Mottramlabs/ESP32-4-Channel-Mains-Current-Sensor/Pictures/201185-Dims.png

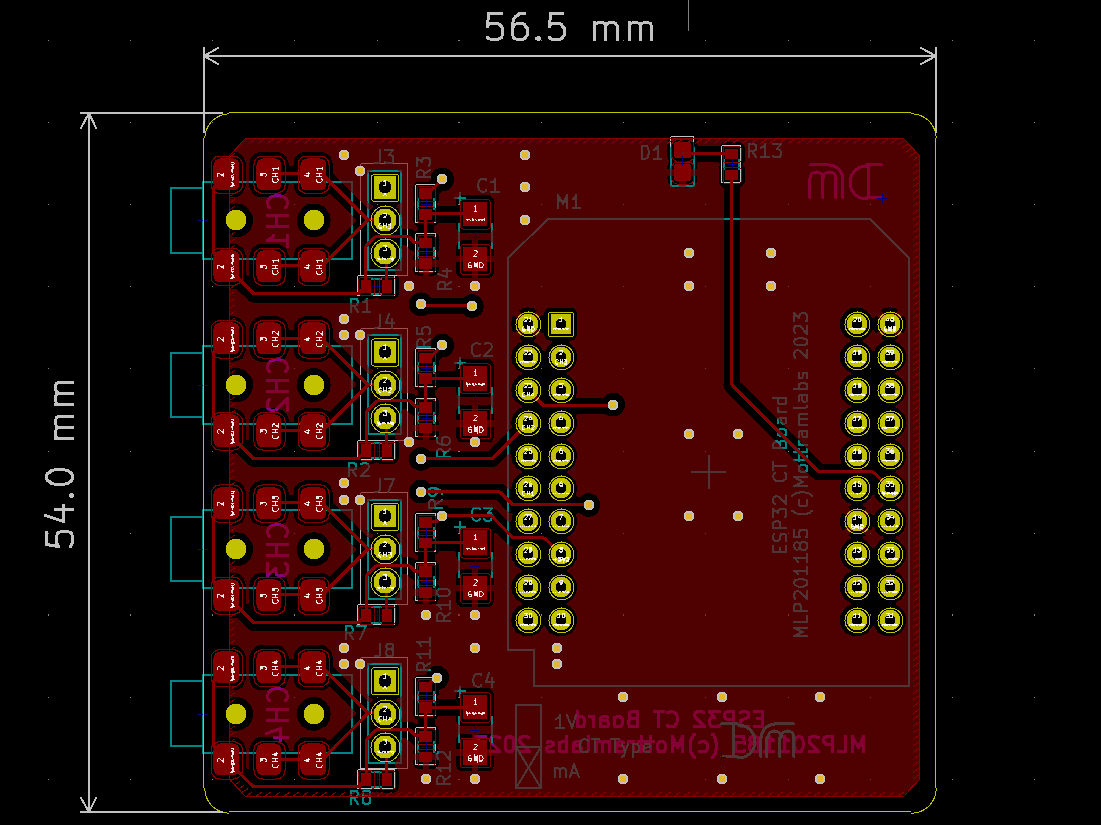
Pictures/201185-Dims.png
