Mottramlabs/ESP32-4-Channel-Mains-Current-Sensor/Pictures/201188-Dims.png

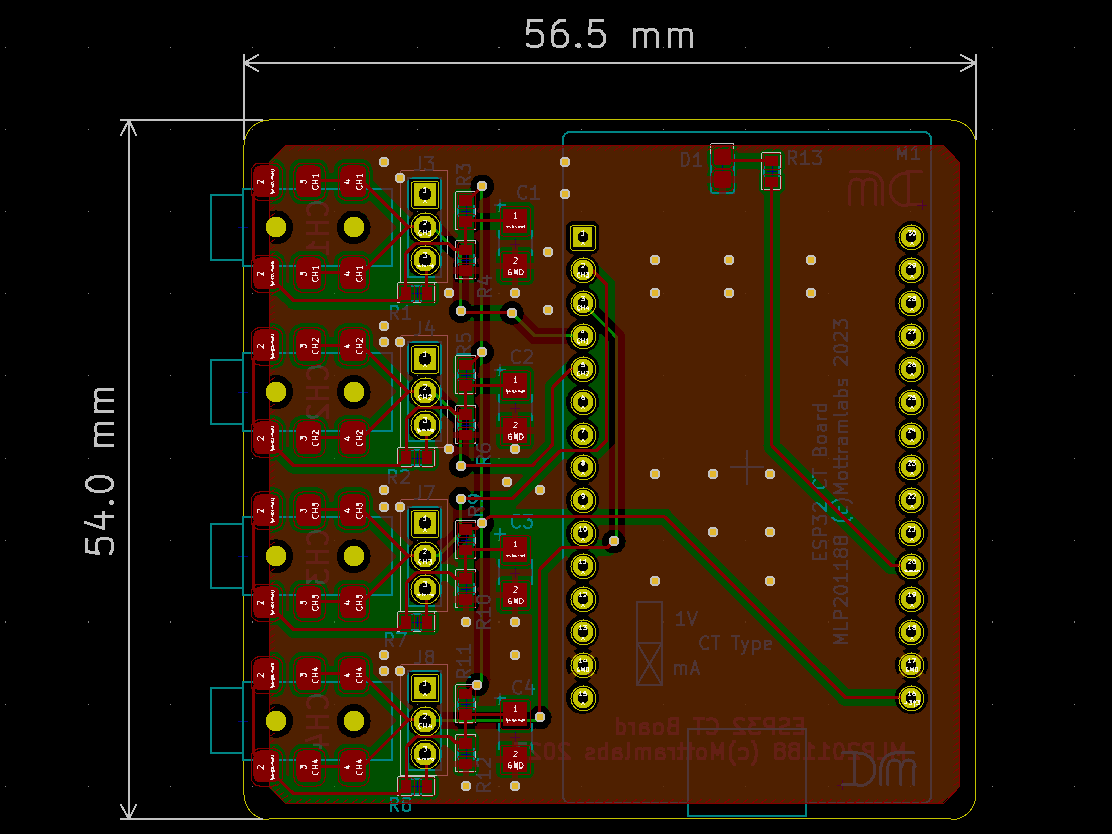
Pictures/201188-Dims.png
