Mottramlabs/ESP32-4-Channel-Mains-Current-Sensor/Pictures/201191-Dims.png

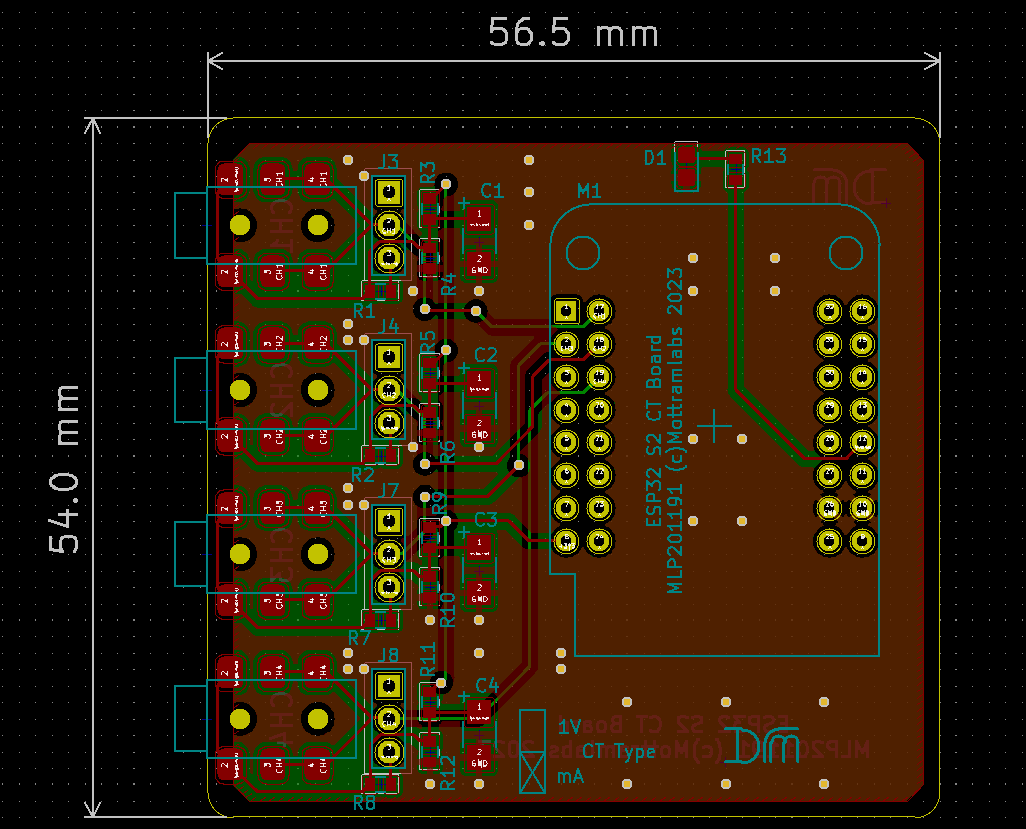
Pictures/201191-Dims.png
