Mottramlabs/ESP32-4-Channel-Mains-Current-Sensor/(threads)

Thread 1 (2023-07-13):

ESP Home Code

talldrin, 2023-07-13:
I just purchased one of these from your ebay store. Do you have the code setup for ESP Home that you could provide? I am planning on using this with home assistant.

swoopgrandchamp, 2023-10-31:
The following code is working in a ESP32.
Note that my voltage sensor comes from homeassistant, you can use a fixed value if you want or don't have a voltage meter.

```
substitutions:
  update_time: never
  disp_name: "house-power-sensor"

esphome:
  name: house-power-sensor
  friendly_name: house-power-sensor

esp32:
  board: esp32dev
  framework:
    type: arduino

# Enable logging
logger:
  level: debug

# Enable Home Assistant API
api:
  encryption:
    key: "USE YOUR ENCRYPTION KEY HERE"

ota:

wifi:
  ssid: !secret wifi_ssid
  password: !secret wifi_password
  ap:
    ssid: "house-power-sensor"
    password: "PROVIDE AP PASSWORD"

time:
  - platform: homeassistant
    id: homeassistant_time

interval:
  - interval: 5s
    then:
      - script.execute: readCTs
script:
  - id: readCTs
    then:
      - component.update: ct1Amps
      - delay: 500ms
      - component.update: ct1Watts
      - delay: 500ms
      - component.update: ct2Amps
      - delay: 500ms
      - component.update: ct2Watts
      - delay: 500ms
      - component.update: ct3Amps
      - delay: 500ms
      - component.update: ct3Watts
      - delay: 500ms
      - component.update: ct4Amps
      - delay: 500ms

switch:
   - platform: restart
     name: "Restart"

sensor:
  - platform: ct_clamp
    sensor: adc_sensor_1
    name: ct1Amps
    id: ct1Amps
    update_interval: never
    sample_duration: 200ms
    filters:
      - calibrate_linear:
          - 0 -> 0
          - 0.07972 -> 7.72

  - platform: adc
    pin: GPIO34
    id: adc_sensor_1
    attenuation: 11db
    internal: true

  - platform: ct_clamp
    sensor: adc_sensor_2
    name: ct2Amps
    id: ct2Amps
    update_interval: never
    sample_duration: 200ms
    filters:
      - calibrate_linear:
          - 0 -> 0
          - 0.08278 -> 7.71

  - platform: adc
    pin: GPIO35
    id: adc_sensor_2
    attenuation: 11db
    internal: true

  - platform: ct_clamp
    sensor: adc_sensor_3
    name: ct3Amps
    id: ct3Amps
    update_interval: never
    sample_duration: 200ms
    filters:
      - calibrate_linear:
          - 0 -> 0
          - 0.08317 -> 7.84

  - platform: adc
    pin: GPIO36
    id: adc_sensor_3
    attenuation: 11db
    internal: true

  - platform: ct_clamp
    sensor: adc_sensor_4
    name: ct4Amps
    id: ct4Amps
    update_interval: never
    sample_duration: 200ms
    #filters:
      #- calibrate_linear:
          #- 0 -> 0
          #- 0.08277 -> 7.80

  - platform: adc
    pin: GPIO39
    id: adc_sensor_4
    attenuation: 11db
    internal: true

  - platform: wifi_signal
    name: "wifi_signal"
    update_interval: 1min
  - platform: uptime
    name: "uptime"
    id: Uptime
    update_interval: 1min

#Watts per channel
  - platform: template
    name: CT1 Watts
    id: ct1Watts
    lambda: return id(ct1Amps).state * id(ic1Volts).state;
    accuracy_decimals: 0
    unit_of_measurement: W
    icon: "mdi:flash-circle"
    update_interval: never

  - platform: template
    name: CT2 Watts
    id: ct2Watts
    lambda: return id(ct2Amps).state * id(ic1Volts).state;
    accuracy_decimals: 0
    unit_of_measurement: W
    icon: "mdi:flash-circle"
    update_interval: never

  - platform: template
    name: CT3 Watts
    id: ct3Watts
    lambda: return id(ct3Amps).state * id(ic1Volts).state;
    accuracy_decimals: 0
    unit_of_measurement: W
    icon: "mdi:flash-circle"
    update_interval: never

  - platform: total_daily_energy
    name: CT1 Total kWh
    power_id: ct1Watts
    filters:
      - multiply: 0.001
    unit_of_measurement: kWh
    icon: "mdi:flash"

  - platform: total_daily_energy
    name: CT2 Total kWh
    power_id: ct2Watts
    filters:
      - multiply: 0.001
    unit_of_measurement: kWh
    icon: "mdi:flash"

  - platform: total_daily_energy
    name: CT3 Total kWh
    power_id: ct3Watts
    filters:
      - multiply: 0.001
    unit_of_measurement: kWh
    icon: "mdi:flash"

  - platform: template
    name: Total Amps
    id: totalAmps
    lambda: return id(ct1Amps).state + id(ct2Amps).state + id(ct3Amps).state ;
    accuracy_decimals: 2
    unit_of_measurement: A
    icon: "mdi:flash"
    update_interval: 15s

  - platform: template
    name: Total Watts
    id: totalWatts
    lambda: return id(totalAmps).state * id(ic1Volts).state;
    accuracy_decimals: 1
    unit_of_measurement: W
    icon: "mdi:flash"
    update_interval: 15s

  - platform: total_daily_energy
    name: Total kWh
    power_id: totalWatts
    filters:
      - multiply: 0.001
    unit_of_measurement: kWh
    icon: "mdi:flash"

  - platform: homeassistant
    name: "Voltage"
    id: ic1Volts
    entity_id: sensor.house_voltage
    internal: true

  - platform: template
    name: Voltage
    id: voltageupdate
    lambda: return id(ic1Volts).state;
    accuracy_decimals: 1
    unit_of_measurement: V
    update_interval: 60s
```

talldrin, 2023-10-31:
Thanks! I will give it try.

Matt2k34, 2023-11-13:
> Thanks! I will give it try.

Did this work for you?

> The following code is working in a ESP32. Note that my voltage sensor comes from homeassistant, you can use a fixed value if you want or don't have a voltage meter.

Thank you for this! This has got me close, but I'm having issues calibrating via calibrate_linear. I think I'm being dense because I'm not sure what number I should be using.

I'm assuming it should be:
[22:49:43][D][sensor:094]: 'ct1Amps': Sending state 0.15046 A with 2 decimals of accuracy
This is my zero load state.
&
[22:50:28][D][sensor:094]: 'ct1Amps': Sending state 0.33105 A with 2 decimals of accuracy
this is with a 2kw resistive load.

I believe this means it should be:
      - calibrate_linear:
          - 0.15046 -> 0
          - 0.33105 -> 8.16

(2000/245v - to give me 8.16A) - I'm having issues regardless how I calculate this with being unable to zero, and receiving either negative or huge wattage numbers.

e..g the above now becomes:
-1,623W instead of zero.

[22:54:24][D][sensor:094]: 'ct1Amps': Sending state -6.62770 A with 2 decimals of accuracy
[22:54:25][D][sensor:094]: 'CT1 Watts': Sending state -1623.78662 W with 0 decimals of accuracy

Any assistance appreciated. I've never done calibrate_linear before and I feel like I'm missing something. I'm using the ESP32 - 30 pin version (devkit v1) and I've tried cutting this down to just the CT1 config to make it easier to read the logs etc, and it was no help.

Any help appreciated. I feel like I'm getting nowhere with the documentation / other examples for calibration

Thanks!

also FYI: Some of the CT4 stuff is missing in your code above :)

PeteBa, 2023-11-14:
By way of example, a common SCT013-000 will theoretically generate a 0V signal at the ESP32 gpio pin when there is a 0 amp load connected through the CT. Similarly, the same CT will generate a 1.1V signal at the ESP32 when there is a 100A load. This provides a pretty good starting point for calibrating the `ct_clamp` platform using the following filter config:

```
- calibrate_linear:
     method: exact
     datapoints:
        - 0 -> 0
        - 1.1 -> 100
```

If you want to improve low current readings then you can remove any load wire through the CT and look for the corresponding "RAW AC" line in the ESPHOME log. The number here is the left side of the correlation mapping as it basically represent the voltage at the gpio pin. The right side should be set to zero as that represents the load current.. In essence, we have added a second correlation line that maps low values to zero rather than having them go negative:

```
[13:18:54][D][ct_clamp:041]: 'Channel 4 Current' - Raw AC Value: 0.001A after 229 different samples (1145 SPS)

- calibrate_linear:
     method: exact
     datapoints:
        - 0 -> 0
        - 0.001 -> 0
        - 1.1 -> 100
```

If you have a multimeter that can measure resistance values then you can go a further step to improve that last correlation pair. The `1.1 -> 100` mapping assumes that the board is using a 22 ohm resistor to convert the 50mA signal that the CT produces at 100A into a 1.1V signal at the gpio pin. This is based on ohms law that voltage = current x resistance. So 0.05 x 22 is equal to 1.1V. However, the resistor is not generally exactly 22 ohms rather it is nominally within +/-1%. Mine is 22.25 ohms. So I can improve the correlation a little bit by using 1.1125 (i.e. 0.05 x 22.25) as the new left side of the last correlation mapping:

- calibrate_linear:
     method: exact
     datapoints:
        - 0 -> 0
        - 0.001 -> 0
        - 1.1125 -> 100
```

This gets me to within a few percent of my reference meter that has higher tolerance resistors, internal voltage reference, 12bit ADC, high frequency sampling/smoothing etc. Not bad for a relatively inexpensive board.

I struggle with using things like a 60W bulb or 2kW space heaters to create correlation maps as there are too many wide tolerances involved that can easily make derived calibrations spurious. For a start these loads are at the low end of the CT's range and you would really want something at the high end. But loads of 80-100A are pretty hard to create and measure in the average home. You then have the difficulty of converting watts to amps given that residential voltages can easily vary +/-10% from nominal. But mileage may vary on this.

Hopefully helpful.
```
substitutions:
  devicename: current-sensor
  friendlyname: Current Sensor

esphome:
  name: ${devicename}
  friendly_name: ${friendlyname}

esp32:
  board: esp32dev
  framework:
    type: arduino

wifi:
  domain: !secret wifi_domain
  ssid: !secret wifi_ssid
  password: !secret wifi_password
  ap:
    ssid: ${devicename}
    password: !secret wifi_ap_password

api:
logger:
ota:

sensor:
  ################ Channel 4 - 100A CT 50mA  ################
  - platform: adc
    pin: GPIO39
    name: Channel 4 ADC
    id: channel_4_adc
    attenuation: 11db
    internal: true

  - platform: ct_clamp
    sensor: channel_4_adc
    name: Channel 4 Current
    id: channel_4_current
    update_interval: 2s
    sample_duration: 200ms
    filters:
      - calibrate_linear:
          method: exact
          datapoints:
            - 0 -> 0
            - 0.001 -> 0           # for CT with non-zero offset
            - 1.1125 -> 100     # For current based CT with 22.25 Ohm burden
      - sliding_window_moving_average:
          window_size: 5
          send_every: 5
          send_first_at: 5
```

Matt2k34, 2023-11-15:
> Hopefully helpful.

100% yes. Thank you very much for this post. It had been driving me crazy and I have (what I think) is a working test bed, and proof that these boards will do exactly what I need (I just need smaller clamps)

Slightly embarrassingly, my issues were:

1. the CT clamp socket being new, when testing the clamp hadn't seated correctly. I must have been knocking the connection and making/breaking it when playing around which is what sent me into wild positive/negative results.
2. Arrows on my CT seemingly are backwards, rather than pointing to the load they point to the source.

I've configured vs 750w, 1250w, and 2000w settings on a resistive heater and it can get within 18w of it at 750/1250 and within 40w of 2000 - More tweaking to do but i'll end up buying some smaller clamps for lower load testing.

Plan is to use the large 100a clamp around connectivity between main consumer unit & loft so I can see directionality into/out of the consumer unit at grid and loft space (solar & batteries) - i'll be able to put about 35-38a load in for that configuration so I *think* that will be ok?

I'll then swap the other inputs to ~20/1V clamps so I can measure lower power / 13a devices.

Honestly, Thank you so much for your help - and for completeness here's (the main sensor section) of the code used. I've pulled in my voltage from HomeAssistant into ESPHome - as the solar battery system has a CT on the mains incoming, I know the incoming voltage pretty accurately. (in the code below, I've used a GROUP (sensor.voltage_group) in Home Assistant, so that if in future I want/need to change the device providing voltage, or I want to average multiple, I can just add the entities in).

It's a shame there's no fleshed out examples on Github / Mottramlabs site - I feel like these boards feel very good quality and they'd sell super well if it was a bit more noob-friendly. (or someone wrote a great guide that didn't assume you knew esphome calibration etc. prior)

Thanks Again!
Matt

`time:
  - platform: homeassistant
    id: homeassistant_time

switch:
   - platform: restart
     name: "Restart"

sensor:

################ Pull Voltage in from Home Assistant  ################

  - platform: homeassistant
    name: "Voltage"
    id: current_voltage_from_ha
    entity_id: sensor.voltage_group
    internal: true

  - platform: template
    name: Voltage
    id: voltageupdate
    lambda: return id(current_voltage_from_ha).state;
    accuracy_decimals: 1
    unit_of_measurement: V
    update_interval: 1s

################ Channel 1 - 100A CT 50mA  ################
  - platform: adc
    pin: GPIO34
    name: Channel 1 ADC
    id: channel_1_adc
    attenuation: 11db
    internal: true

  - platform: ct_clamp
    sensor: channel_1_adc
    name: Channel 1 Current
    id: channel_1_current
    update_interval: 2s
    sample_duration: 200ms
    filters:
      - multiply: 4.0
      - calibrate_linear:
          method: exact
          datapoints:
            #- 0 -> 0
            - 0.003 -> 0           # for CT with non-zero offset
            - 0.089 -> 2     # For current based CT with 22.25 Ohm burden
      - sliding_window_moving_average:
          window_size: 3
          send_every: 3
          send_first_at: 3

##Watts
  - platform: template
    name: CT1 Watts
    id: channel_1_watts
    lambda: return id(channel_1_current).state * id(current_voltage_from_ha).state;
    accuracy_decimals: 0
    unit_of_measurement: W
    icon: "mdi:flash-circle"
    update_interval: 2s

 ################ Channel 2 - 100A CT 50mA  ################
  - platform: adc
    pin: GPIO35
    name: Channel 2 ADC
    id: channel_2_adc
    attenuation: 11db
    internal: true

  - platform: ct_clamp
    sensor: channel_2_adc
    name: Channel 2 Current
    id: channel_2_current
    update_interval: 2s
    sample_duration: 200ms
    filters:
      #- calibrate_linear:
          #method: exact
          #datapoints:
            #- 0 -> 0
            #- 0.002 -> 0           # for CT with non-zero offset
            #- 1.1115 -> 100     # For current based CT with 22.25 Ohm burden
      - sliding_window_moving_average:
          window_size: 5
          send_every: 5
          send_first_at: 5

##Watts
  - platform: template
    name: CT2 Watts
    id: channel_2_watts
    lambda: return id(channel_2_current).state * id(current_voltage_from_ha).state;
    accuracy_decimals: 0
    unit_of_measurement: W
    icon: "mdi:flash-circle"
    update_interval: never

  ################ Channel 3 - 100A CT 50mA  ################

  - platform: adc
    pin: GPIO36
    name: Channel 3 ADC
    id: channel_3_adc
    attenuation: 11db
    internal: true

  - platform: ct_clamp
    sensor: channel_3_adc
    name: Channel 3 Current
    id: channel_3_current
    update_interval: 2s
    sample_duration: 200ms
    filters:
      #- calibrate_linear:
          #method: exact
          #datapoints:
            #- 0 -> 0
            #- 0.002 -> 0           # for CT with non-zero offset
            #- 3.3325 -> 300     # For current based CT with 22.25 Ohm burden
      - sliding_window_moving_average:
          window_size: 5
          send_every: 5
          send_first_at: 5

##Watts
  - platform: template
    name: CT3 Watts
    id: channel_3_watts
    lambda: return id(channel_3_current).state * id(current_voltage_from_ha).state;
    accuracy_decimals: 0
    unit_of_measurement: W
    icon: "mdi:flash-circle"
    update_interval: never

################ Channel 4 - 100A CT 50mA  ################
  - platform: adc
    pin: GPIO39
    name: Channel 4 ADC
    id: channel_4_adc
    attenuation: 11db
    internal: true

  - platform: ct_clamp
    sensor: channel_4_adc
    name: Channel 4 Current
    id: channel_4_current
    update_interval: 2s
    sample_duration: 200ms
    filters:
      #- calibrate_linear:
          #method: exact
          #datapoints:
            #- 0 -> 0
            #- 0.002 -> 0           # for CT with non-zero offset
            #- 1.1125 -> 100     # For current based CT with 22.25 Ohm burden
      - sliding_window_moving_average:
          window_size: 5
          send_every: 5
          send_first_at: 5

##Watts
  - platform: template
    name: CT4 Watts
    id: channel_4_watts
    lambda: return id(channel_4_current).state * id(current_voltage_from_ha).state;
    accuracy_decimals: 0
    unit_of_measurement: W
    icon: "mdi:flash-circle"
    update_interval: never

############# Total Daily Energy - kWh
  - platform: total_daily_energy
    name: CT1 Total kWh
    power_id: channel_1_watts
    filters:
      - multiply: 0.001
    unit_of_measurement: kWh
    icon: "mdi:flash"

############# Total Amps - A
  - platform: template
    name: Total Amps
    id: totalAmps
    lambda: return id(channel_1_current).state + id(channel_2_current).state + id(channel_3_current).state + id(channel_4_current).state ;
    accuracy_decimals: 2
    unit_of_measurement: A
    icon: "mdi:flash"
    update_interval: 15s

############# Total Watts - W
  - platform: template
    name: Total Watts
    id: totalWatts
    lambda: return id(totalAmps).state * id(current_voltage_from_ha).state;
    accuracy_decimals: 1
    unit_of_measurement: W
    icon: "mdi:flash"
    update_interval: 15s

  - platform: total_daily_energy
    name: Total kWh
    power_id: totalWatts
    filters:
      - multiply: 0.001
    unit_of_measurement: kWh
    icon: "mdi:flash"`

PeteBa, 2023-11-16:
Matt, glad the comments were useful. I picked up a few things in your response that I thought interesting and raised a couple of questions/follow-ups. Hope that is OK.

You mention that the CT direction labelling is wrong, can I ask how you determined that ? This board alone cannot measure flow direction as you need simultaneous access to voltage phase to achieve that. If indeed the label is wrong then you probably have counterfeit CTs which is unfortunately common through some online marketplaces. If so then I would replace the CTs through a specialist supplier.

I see you are using a standard two element heater to create your calibration maps. Can I ask if you have a reference meter to reliably determine the actual wattage of the unit before trying to calibrate the CT ? I also have a 750/1250/2000W heater but the numbers on the box are very different to the actual wattage of the device which is 870/1,340/2,210. If I used the box numbers to calibrate the CT then I would be building in a ~10% error. I would be better off sticking with the theoretical calibration  numbers or alternatively buying a relatively cheap but somewhat accurate "kill-a-watt" style device.

One thing to be aware of, If you are going to use lower value CTs then be very careful to only use them on circuits that are guaranteed to have a maximum current load under the nominal value of the CT. For example, passing a 10A load through a 5A CT will likely fry the ESP32 gpio pin. I would suggest always using a higher value CT than the fuse of the circuit being measured for safety.

For completeness, if using a voltage based CT (rather than the 50mA type above). Then the starting point calibration is even easier. The CT will generate 0V when the load is 0A and 1V when the load is at it's nominal value. So for a 30A CT the config would be:

```
- calibrate_linear:
     method: exact
     datapoints:
        - 0 -> 0
        - 1 -> 30
```

Matt2k34, 2023-11-16:
> Hope that is OK.

Of course :D feel free, to ask anything ^

> If indeed the label is wrong then you probably have counterfeit CTs which is unfortunately common through some online marketplaces.

They were indeed, Cheap & cheerful imports from eBay. I'd have to re-test to see if it makes a difference, but in early testing (albeit with issues) it seemed to. I'll see where I can get them for a decent price that might be a little less grey market. These CTs feel pretty shoddy in comparison to other clamps I've used for other things (e.g. EV charger, Solar battery charger). The "YHDC" print on the side I don't think is overly clear making me think they're potentially none genuine. (unless that's "normal")

> Can I ask if you have a reference meter to reliably determine the actual wattage of the unit before trying to calibrate the CT ?
Yes - I've got a 3pin "kill-a-watt" style meter which I trust as accurate (or at least accurate enough) - my heater comes in pretty much smack on the money of the 750/1250/2000.  I've also tested this against a Shelly 1PM which is "there abouts" on my heater & plug in K-A-W. Although not perfect it's probably "good enough" for my needs.

I'll do some better calibration and setup now I know that "this works" as a solution, this has all been a bit rough and ready as a POC really.

> I would suggest always using a higher value CT than the fuse of the circuit being measured for safety.

Yep :) So the thought being 20A/1v CTs will give me enough to cover 13A/220V appliances with plenty of headroom to protect the esp. I'll only use the larger 100A clamps for the cabling between my solar & battery setup, and the main consumer unit (I intend to add extra battery storage meaning it'll be able to push/pull about 48A to/from the main consumer unit under full load - IF I can generate that much usage :) ). Although it's less than "perfect" I'll probably stick to 20A CTs for all "plug in" device monitoring - as anything smaller will likely be fused in the plug at 13A anyway.

Thank you for the example for the voltage CT, this entire thread has been extremely helpful. I found the calibration process infuriating as everyone mentions how to do it - but no one has a "did you check this?" type troubleshooting steps when it doesn't do what you expect.

Joshndroid, 2024-03-25:
Sorry everyone for the bump in this.
I picked up the 4 Port ESP32-s2 version of the boards... Wemos ESP32-S2 Mini
After fighting for a couple days (dead esp32-s2 boards) and ending up needing to bypass the use of esphome web and manually flashing it I at least have a single esp32-s2 board seen by home assistant.
I realised that once i plugged it into the 4-port board, it would no longer find the device.
Searching around I have found here and realised I would need a bit more code to get this going.
I used the example above and slightly changing the top-most section I seem to get an error in relation to the ADC pins.
I have tried searching online for the ADC pins and it seems that the supplied GPIO pins above seem to be correct.

`sensor.adc: [source /config/esphome/wemoss2-4-port.yaml:80]
  platform: adc

  ESP32S2 doesn't support ADC on this pin.
  pin: GPIO34
  id: adc_sensor_1
  attenuation: 11db
  internal: True
sensor.adc: [source /config/esphome/wemoss2-4-port.yaml:97]
  platform: adc

  ESP32S2 doesn't support ADC on this pin.
  pin: GPIO35
  id: adc_sensor_2
  attenuation: 11db
  internal: True
sensor.adc: [source /config/esphome/wemoss2-4-port.yaml:114]
  platform: adc

  ESP32S2 doesn't support ADC on this pin.
  pin: GPIO36
  id: adc_sensor_3
  attenuation: 11db
  internal: True
sensor.adc: [source /config/esphome/wemoss2-4-port.yaml:131]
  platform: adc

  ESP32S2 doesn't support ADC on this pin.
  pin: GPIO39
  id: adc_sensor_4
  attenuation: 11db
  internal: True`

Any tips for this eager user to get this to work (I have YHDC sct-13 clamps 100A/50MA to use on the house to replace a pain in the ass efergy monitor

Joshndroid, 2024-03-29:
I have managed to work out a few things on getting this going... i Have linked this issue in my own separate notes issue to help others with the style that I have.

Thread 2 (2023-09-18):

Bias voltage too high for ESP32 ?

PeteBa, 2023-09-18:
I have a 5 amp CT (SCT013-005) with a 1V output. Unfortunately, current readings appear to max out at around 4.7 amps. I am using the ESP32-S2 board, have the jumper set to 1V and using 11db attenuation.

Looking at the board schematic, I can see the bias voltage is set to 1.65V (i.e. 3.3/2). Given the CT is 1V then the ADC needs to be able to measure voltages between 0.65-2.65V to cover the ct range. However, the esspresif specs [here](https://docs.espressif.com/projects/arduino-esp32/en/latest/api/adc.html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,analogSetAttenuation,%C2%B6,-This%20function%20is) states the widest voltage range to be 0-2.5V when configured with 11db attenuation. Unfortunately, this doesn't cover the full working range of the CT and I suspect the readings are clipped at the high end.

Have I understood this correctly ? I'm a bit new to this stuff so could be misunderstanding things here but, if correct, would it make sense to alter the bias voltage to, say, 1.25V, allowing the full range of measurements.

pskillen, 2023-11-13:
Did you ever resolve this? I'm having trouble getting mine to read anything but zero. The ADC gives a nice floating value when the expansion board isnt connected, but I get the same fixed voltage reading across all 4 channels when the board is connected

Below is with a SCT013-000 (100A) CT with about 30A AC running through it, on a ESP32-WROOM-32. The 1.01400v is the same across all 4 channels
```
[19:29:21][D][ct_clamp:041]: 'Car charger CT' - Raw AC Value: 0.000A after 1 different samples (5 SPS)
[19:29:21][D][sensor:094]: 'Car charger CT': Sending state 0.00000 A with 2 decimals of accuracy
[19:29:25][D][sensor:094]: 'ct_input_1': Sending state 1.01400 V with 2 decimals of accuracy
```

PeteBa, 2023-11-13:
Looking at your log extract, it shows 5 samples per second for the ADC. This should be reading many 100s of samples if setup correctly. You could either have the ESPHome sampling period way to short or the CT is not properly connected. Could the CT be wired incorrectly to the phono jack ? Also, double check, you are shorting the two right-most pins of the 1V/50mA jumper.

My original post above relates to a hardware design choice on the ESP32-S2 board that sets the bias voltage a bit high. This causes readings to be low when measuring currents higher than 50-60% of the CT's nominal value. This can be addressed using the `calibrate_linear` filter.

I use the ESPHome config below for the ESP32-S2 board:

```
esphome:
  name: current-sensor-s2

esp32:
  board: lolin_s2_mini
  variant: ESP32S2
  framework:
    type: arduino

wifi:
  domain: !secret wifi_domain
  ssid: !secret wifi_ssid
  password: !secret wifi_password
  ap:
    password: !secret wifi_ap_password

api:
logger:
ota:

sensor:
################ Channel 4 - 100A CT 50mA  ################
  - platform: adc
    pin: GPIO4
    name: "Current Sensor S2 Channel 4 ADC"
    id: channel_4_adc
    attenuation: 11db
    internal: true

  - platform: ct_clamp
    sensor: channel_4_adc
    name: "Current Sensor S2 Channel 4 Current"
    update_interval: 2s
    sample_duration: 200ms
    filters:
      - calibrate_linear:
          method: exact
          datapoints:
            - 0 -> 0
            - 0.514 -> 51.4
            - 0.788 -> 106.08
      - sliding_window_moving_average:
          window_size: 5
          send_every: 5
          send_first_at: 5
```

pskillen, 2023-11-15:
You're right, my problem is unrelated to this ticket, but you have solved my problem. It was the attenuation - I should have read the docs, but I had convinced myself that it did work at one point, so I assumed I didn't need attentuation. Thanks!

Thread 3 (2024-03-17):

Floating voltage reading when no clamps are plugged in

siparker, 2024-03-17:
I have just put the esphome code from the other issue thread onto my board and plugged just a single clamp into channel 1.

channel 2 and 4 have no reading but channel 3 is reading around 0.2A to 0.4A with nothing plugged into it.

Thread 5 (2024-03-29):

ESP Home Code - ESP32-S2 - Wemos Style - Notes

Joshndroid, 2024-03-29:
Hello all who may find this.

After obtaining the code provided in the other issue - https://github.com/Mottramlabs/ESP32-4-Channel-Mains-Current-Sensor/issues/1

I noticed that the ADC provided would list an error where it says

`ESP32S2 doesn't support ADC on this pin.`

Knocking over a fair bit of googling, etc I couldn't get a grasp on it until i found that the ADC pins are slightly different.
Using this site here - https://www.studiopieters.nl/esp32-s2-pinout/

```
GPIO1  ADC1_CH0
GPIO2 ADC1_CH1
GPIO3 ADC1_CH2
GPIO4 ADC1_CH3

```

Don't use the ADC2 pins listed as these are disabled for wifi

Digging through some more within the schematics of the 4 port board https://github.com/Mottramlabs/ESP32-4-Channel-Mains-Current-Sensor/blob/main/SCH201191.pdf

It listed that the barrel jacks appear to go to 1, 2, 3 & 4.

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

I updated that code to change the GPIO to 1,2,3 & 4 and it validated and got it installed no issues.

Next issue it appeared is that it seemed like the device would randomly disconnect...
Originally i thought it was a power issue but digging through some more docs on ESPHome (https://esphome.io/components/wifi.html) it appears that there is a 'light' power save feature with these so that it must turn off/on wifi. This may be okay later down the line but when your trying to set the device up it makes it super frustrating it just disconnecting. Under the wifi listed the power saving as none.

```
wifi:
  # ...
  power_save_mode: none
```

This has stopped it disconnecting after about 90 seconds or so... This may also assist in getting the dam thing to flash as this disconnect would be a pain in trying to flash it OTA wirelessly during my updates/changes to the yaml.

I have been typing this out for a fair while now and the device is yet to disconnect =]

I found it easier to set a static IP so i have done this in both my DHCP settings within the router but have also backed this up within the device yaml with this from https://esphome.io/components/wifi.html

```
wifi:
  # ...
  manual_ip:
    # Set this to the IP of the ESP
    static_ip: 10.0.0.42
    # Set this to the IP address of the router. Often ends with .1
    gateway: 10.0.0.1
    # The subnet of the network. 255.255.255.0 works for most home networks.
    subnet: 255.255.255.0
```

When you watch the device connect however it does not have any DNS listed so the addition of a DNS1 & DNS2 parameter into the wifi section above below subnet will get you sorted (if necessary)

In essence your WiFi section within the yaml would end up looking something like this

```
wifi:
  ssid: !secret wifi_ssid
  password: !secret wifi_password

  # Optional manual IP
  manual_ip:
    static_ip: 10.0.0.42
    gateway: 10.0.0.1
    subnet: 255.255.255.0
    dns1: 10.0.0.1

  #powersaving WiFi
  power_save_mode: none
```

dantheg1t, 2024-05-24:
Hi @Joshndroid

I have aquired the same hardware as you and I thank you for the notes you have provided, helping to get this setup and working.

Have you managed to get this fully deployed or are you still having issues?

Joshndroid, 2024-05-24:
Hi @dantheg1t

No I played around a little but have put it in the drawer for now.

Have you had any luck with it?

dantheg1t, 2024-05-24:
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

I am just in the process of getting things configured. Haven't had my CT's delivered yet, so early days.

dantheg1t, 2024-05-24:
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

So what are the remaining issues that you have?

Joshndroid, 2024-05-24:
The device seems to go to sleep/off after a while and doesn't want to wake up.

Not sure what the configuration is to disable this. I don't quite understand why.

I put the clamp around my power cable for the pc Setup just to see if I could get a reading and it didn't seem like it.. But I think I need to sort the sleep thing first before I tackle the next bit

jtenniswood, 2024-06-15:
I'm struggling to setup this device, have you had any joy getting it working? If yes, could you share your code!
Thanks!

TheNeutrinoRaged, 2024-12-19:
Thanks for your thread, I got my eps32 s2 and 100/50ma sct working with home assistant (remotely with mqtt) by following along and referring back to issue #1

I've put my tweaked code below, I actually bought a 4 port board but only have 1 Ct for now.

<details>
<summary>esphome code</summary>

```
esphome:
  name: esp32s2pm
  friendly_name: esp32s2pm

esp32:
  board: lolin_s2_mini
  framework:
    type: esp-idf

# Enable logging
logger:
  level: debug

wifi:
  ssid: !secret wifi_ssid
  password: !secret wifi_password

time:
  - platform: sntp
    id: sntp_time
    timezone: Europe/London

interval:
  - interval: 5s
    then:
      - script.execute: readCTs
script:
  - id: readCTs
    then:
      - component.update: ct1Amps
      - delay: 500ms
      - component.update: ct1Watts
      - delay: 500ms

switch:
   - platform: restart
     name: "Restart"

sensor:
  - platform: ct_clamp
    sensor: adc_sensor_1
    name: ct1Amps
    id: ct1Amps
    update_interval: never
    sample_duration: 200ms
    filters:
        - calibrate_linear:
             method: exact
             datapoints:
                - 0 -> 0
                - 0.004 -> 0
                - 1.015 -> 100

  - platform: adc
    pin: GPIO1
    id: adc_sensor_1
    attenuation: 11db
    internal: true

  - platform: wifi_signal
    name: "wifi_signal"
    update_interval: 1min
  - platform: uptime
    name: "uptime"
    id: Uptime
    update_interval: 1min

#Watts per channel
  - platform: template
    name: CT1 Watts
    id: ct1Watts
    lambda: return id(ct1Amps).state * 240;
    accuracy_decimals: 0
    unit_of_measurement: W
    icon: "mdi:flash-circle"
    update_interval: never

  - platform: total_daily_energy
    name: CT1 Total kWh
    power_id: ct1Watts
    filters:
      - multiply: 0.001
    unit_of_measurement: kWh
    icon: "mdi:flash"

mqtt: <removed>
```

</details>

Joshndroid, 2024-12-20:
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

Amazing.
I have taken your example with slight modification and used it on my own device which is now seen in HA :)

I wanted to try and test the output with just a cable on a power bar however my output is listed as 0 watts and amps.. Does yours seem to work on a regular power cable I assume my issue could be the shielding/sheeth blocking it

TheNeutrinoRaged, 2024-12-21:
Apologies if you know this already but the ct clamp must only go around the live wire, if it's around both live and neutral they cancel each other out and you will get 0 watts (that's my layman's understanding at least).

Maybe that's why you get 0 when testing? I cut the insulation on a hair dryer flex in order to clamp just the live wire to test (obviously I made the insulation good afterwards).

I've had pretty good uptime, looking at my HA history it randomly restarted a couple times but it comes right back online.

<details>

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

</details>

Joshndroid, 2024-12-21:
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

That will be exactly why I get zero, lol.. Whoops.. Was too excited after your reply I just threw it straight on the first cable next to me and started working on the yaml lol. Didn't even think about that.

I also think the issue I had with the device turning off is actually an issue with the device itself. I had another one laying about and that seems to hold connection far better. The issue with that one is the pins are on the opposite side so waiting on a couple replacements and I think I'll be very close to being up and running.

My yaml looks a bit different but I do have it working in MQTT with all 4 ports as well as the reboot, uptime, signal strength, etc showing. I may be able to slim it a tad as I was getting creative thinking deep sleep was my issue instead if the device itself being buggy

Which side do you have your jumper cap on for the ports?

Thanks again I will update here in a couple days.

jtenniswood, 2024-12-21:
Interesting, I'm having the same issue, I can monitor the main power coming in, but when trying any of the any circuits I get zero. Annoying but logical.

TheNeutrinoRaged, 2024-12-22:
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

My jumper cap is on mA (pins 2 and 3 in the diagram from mottramlabs.com) as my Ct outputs 0-50mA, I believe pins 1 and 2 are for CTs that output 0-1V.

<details>

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

</details>

Joshndroid, 2024-12-22:
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

Excellent just making sure for the calibration numbers in the yaml

Joshndroid, 2024-12-24:
Right @TheNeutrinoRaged I have my replacement device and my yaml appears to be working.
What i seem to have issue with at the moment is my calibration values never seem to work out.
I am running 240V supply as yourself so left the lamda alone.
I have a voltmeter with clamp style Amp reader in the post but in the meantime I was having a play with my meross energy meter.
I am seeing on the reference meross device 1860Wh, with the esphome device seeing 200W.
I have been playing around with values and i cant seem to get close.
I have a 500A:50ma CT clamp

Any tips for me in getting better numbers

TheNeutrinoRaged, 2024-12-24:
I followed instructions in [this post](https://github.com/Mottramlabs/ESP32-4-Channel-Mains-Current-Sensor/issues/1#issuecomment-1810359627) from from #1 to calibrate.

My kill-a-watt died so I couldn't measure watts of a known load, but I had a multimeter to measure the burden resistor, and when I compared readings against my IHD they were reasonably similar.

I wouldn't be surprised if I'm off by quite a bit, but it'll do for now 🤞

Joshndroid, 2024-12-28:
Alright, I think I have this setup within home assistant.
I am waiting on an outdoor project box so i can deploy it properly.

As a note for the calibration values - Use the logs to get the A output from the clamp, not the value displayed in the MQTT.

My yaml builds on that of @TheNeutrinoRaged and only has some differences, however i was unable to just copy and paste their code and get my devices working so it may lie somewhere between the two or it may be either one to get you going. I would not be anywhere near this without @TheNeutrinoRaged help however, its been a long time coming and I'm stoked its working at this time.

For deployment I am hoping to use a USB battery bank with a solar panel also plugged in, so see how we go. I don't have a power outlet within my meter box so unable to hardwire it in at this time.

`esphome:
  name: esp32s2pm
  friendly_name: esp32s2pm

esp32:
  board: lolin_s2_mini
  framework:
    type: esp-idf

# Enable logging
logger:
  level: debug

mqtt:
  broker: 10.0.0.43
  port: 1883
  username: home-assistant-mqtt
  password: !secret mqtt_password
  discovery: true
  discovery_prefix: homeassistant
  keepalive: 60s  # Add keepalive interval

ota:
  - platform: esphome
    password: "yesbigpassword"

wifi:
  ssid: !secret wifi_ssid
  password: !secret wifi_password

  # Optional manual IP
  manual_ip:
    static_ip: 10.0.0.4
    gateway: 10.0.0.1
    subnet: 255.255.255.0
    dns1: 10.0.0.1

  #powersaving WiFi
  power_save_mode: none

  # Enable fallback hotspot (captive portal) in case wifi connection fails
  ap:
    ssid: "Esp32S2Pm Fallback Hotspot"
    password: "yesnumber"

captive_portal:

time:
  - platform: sntp
    id: sntp_time
    timezone: Australia/Brisbane

interval:
  - interval: 5s
    then:
      - script.execute: readCTs
      - lambda: 'ESP_LOGD("main", "Heartbeat to keep the device active");'
script:
  - id: readCTs
    then:
      - component.update: ct1Amps
      - delay: 500ms
      - component.update: ct1Watts
      - delay: 500ms
      - component.update: ct2Amps
      - delay: 500ms
      - component.update: ct2Watts
      - delay: 500ms
      - component.update: ct3Amps
      - delay: 500ms
      - component.update: ct3Watts
      - delay: 500ms
      - component.update: ct4Amps
      - delay: 500ms
      - component.update: ct4Watts
      - delay: 500ms

switch:
   - platform: restart
     name: "Restart"

sensor:
  - platform: wifi_signal
    name: "wifi_signal"
    update_interval: 1min
    state_topic: "homeassistant/sensor/wifi_signal/state"

  - platform: uptime
    name: "uptime"
    id: Uptime
    update_interval: 1min
    state_topic: "homeassistant/sensor/uptime/state"

  - platform: ct_clamp
    sensor: adc_sensor_1
    name: ct1Amps
    id: ct1Amps
    update_interval: never
    sample_duration: 200ms
    filters:
        - calibrate_linear:
             method: exact
             datapoints:
             - 0.0 -> 0.0          # No current -> No output
             - 0.004 -> 0.359      # 0.004A ESP reading -> 0.359A Test clamp
             - 0.007 -> 0.550      # 0.007A ESP reading -> 0.550A Test clamp
             - 0.066 -> 8.20       # 0.066A ESP reading -> 8.20A Test clamp

  - platform: adc
    pin: GPIO1
    id: adc_sensor_1
    attenuation: 12db
    internal: true

  - platform: ct_clamp
    sensor: adc_sensor_2
    name: ct2Amps
    id: ct2Amps
    update_interval: never
    sample_duration: 200ms
    filters:
        - calibrate_linear:
             method: exact
             datapoints:
             - 0.0 -> 0.0          # No current -> No output
             - 0.004 -> 0.359      # 0.004A ESP reading -> 0.359A Test clamp
             - 0.007 -> 0.550      # 0.007A ESP reading -> 0.550A Test clamp
             - 0.066 -> 8.20       # 0.066A ESP reading -> 8.20A Test clamp

  - platform: adc
    pin: GPIO2
    id: adc_sensor_2
    attenuation: 12db
    internal: true

  - platform: ct_clamp
    sensor: adc_sensor_3
    name: ct3Amps
    id: ct3Amps
    update_interval: never
    sample_duration: 200ms
    filters:
        - calibrate_linear:
             method: exact
             datapoints:
             - 0.0 -> 0.0          # No current -> No output
             - 0.004 -> 0.359      # 0.004A ESP reading -> 0.359A Test clamp
             - 0.007 -> 0.550      # 0.007A ESP reading -> 0.550A Test clamp
             - 0.066 -> 8.20       # 0.066A ESP reading -> 8.20A Test clamp

  - platform: adc
    pin: GPIO3
    id: adc_sensor_3
    attenuation: 12db
    internal: true

  - platform: ct_clamp
    sensor: adc_sensor_4
    name: ct4Amps
    id: ct4Amps
    update_interval: never
    sample_duration: 200ms
    filters:
        - calibrate_linear:
             method: exact
             datapoints:
             - 0.0 -> 0.0          # No current -> No output
             - 0.004 -> 0.359      # 0.004A ESP reading -> 0.359A Test clamp
             - 0.007 -> 0.550      # 0.007A ESP reading -> 0.550A Test clamp
             - 0.066 -> 8.20       # 0.066A ESP reading -> 8.20A Test clamp

  - platform: adc
    pin: GPIO4
    id: adc_sensor_4
    attenuation: 12db
    internal: true

  - platform: template
    name: CT1 Watts
    id: ct1Watts
    lambda: return id(ct1Amps).state * 240;
    accuracy_decimals: 0
    unit_of_measurement: W
    icon: "mdi:flash-circle"
    update_interval: never
    state_topic: "homeassistant/sensor/ct1_watts/state"

  - platform: total_daily_energy
    name: CT1 Total kWh
    power_id: ct1Watts
    filters:
      - multiply: 0.001
    unit_of_measurement: kWh
    icon: "mdi:flash"
    state_topic: "homeassistant/sensor/ct1_total_kwh/state"

  - platform: template
    name: CT2 Watts
    id: ct2Watts
    lambda: return id(ct2Amps).state * 240;
    accuracy_decimals: 0
    unit_of_measurement: W
    icon: "mdi:flash-circle"
    update_interval: never
    state_topic: "homeassistant/sensor/ct2_watts/state"

  - platform: total_daily_energy
    name: CT2 Total kWh
    power_id: ct2Watts
    filters:
      - multiply: 0.001
    unit_of_measurement: kWh
    icon: "mdi:flash"
    state_topic: "homeassistant/sensor/ct2_total_kwh/state"

  - platform: template
    name: CT3 Watts
    id: ct3Watts
    lambda: return id(ct3Amps).state * 240;
    accuracy_decimals: 0
    unit_of_measurement: W
    icon: "mdi:flash-circle"
    update_interval: never
    state_topic: "homeassistant/sensor/ct3_watts/state"

  - platform: total_daily_energy
    name: CT3 Total kWh
    power_id: ct3Watts
    filters:
      - multiply: 0.001
    unit_of_measurement: kWh
    icon: "mdi:flash"
    state_topic: "homeassistant/sensor/ct3_total_kwh/state"

  - platform: template
    name: CT4 Watts
    id: ct4Watts
    lambda: return id(ct4Amps).state * 240;
    accuracy_decimals: 0
    unit_of_measurement: W
    icon: "mdi:flash-circle"
    update_interval: never
    state_topic: "homeassistant/sensor/ct4_watts/state"

  - platform: total_daily_energy
    name: CT4 Total kWh
    power_id: ct4Watts
    filters:
      - multiply: 0.001
    unit_of_measurement: kWh
    icon: "mdi:flash"
    state_topic: "homeassistant/sensor/ct4_total_kwh/state"`

Thread 6 (2024-08-09):

Are the transient capacitors (C1-C4) really 10uF? (vs. say 10nF)

puterboy, 2024-08-09:
10uF @60Hz has an impedance of 265 Ohms (and 318 Ohms at 50Hz).
This would be a low resistance (impedance) path relative to the lower leg of the voltage divider (R=10K) -- giving a parallel impedance of  258 Ohms.
So the reference level of the voltage divider would be:` .025 * 3.3V = .08V`, rather than the desired `0.5 * 3.3V = 1.65V`.

Should it be 10nF?
That would have an impedance of 265K at 60Hz.
Giving the voltage divider reference point a voltage of 1.62V

Thread 7 (2024-08-19):

Physically mounting the board

madjetey, 2024-08-19:
I'm looking to mount the board onto a prototype board with nylon isolation columns that will sit in a case for easy mounting and maintenance.

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

Is there a safe place to drill on the MLP201188 board? I'm guessing under the ESP mounts between the traces
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

Thread 8 (2024-11-28):

Non 0 values without CT clamps

uxieme, 2024-11-28:
Hi,

Is everything fine with my board?
I am getting some weird numbers without any CT.
I see that most of the people here get 0, and I for some reason get 0.004, 0.003, 0.002A

[18:14:56][D][ct_clamp:041]: 'ct1Amps' - Raw AC Value: 0.003A after 472 different samples (2360 SPS)
[18:14:56][D][sensor:094]: 'ct1Amps': Sending state 0.00316 A with 2 decimals of accuracy

And it jumps all the time.

Config:
```
sensor:
  - platform: ct_clamp
    sensor: adc_sensor_1
    name: ct1Amps
    id: ct1Amps
    update_interval: 2s
    sample_duration: 200ms

  - platform: adc
    pin: GPIO34
    id: adc_sensor_1
    attenuation: 11db
    internal: true
```

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

Thorstorm, 2024-12-01:
I'm having the same issues. Where have you found other cases that are getting 0 as value when no CT clamp is plugged in?
