Mottramlabs/ESP32-4-Channel-Mains-Current-Sensor/SCH201191.pdf

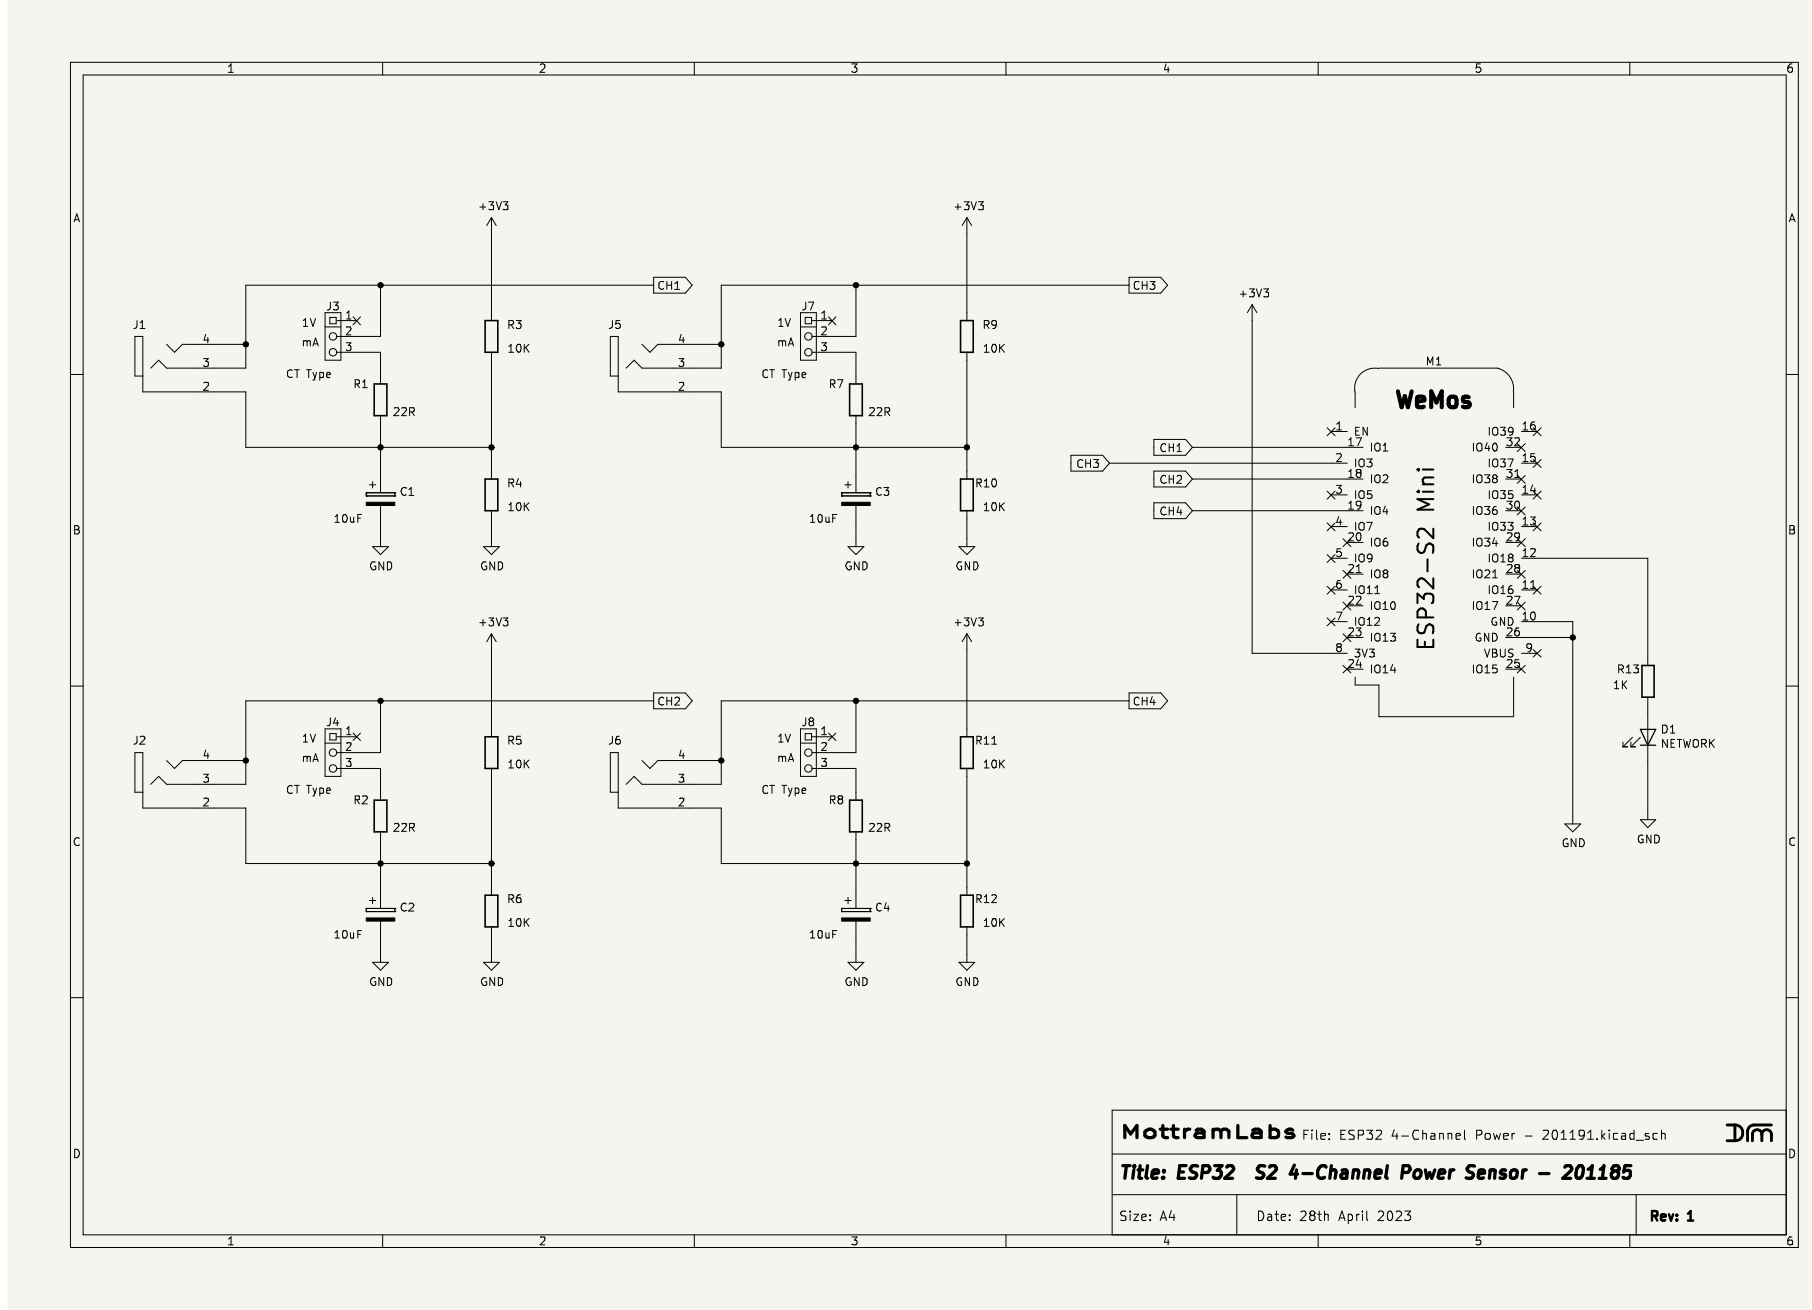
[picture p7: page 1]
