Mottramlabs/ESP32-4-Channel-Mains-Current-Sensor/SCH201185.pdf

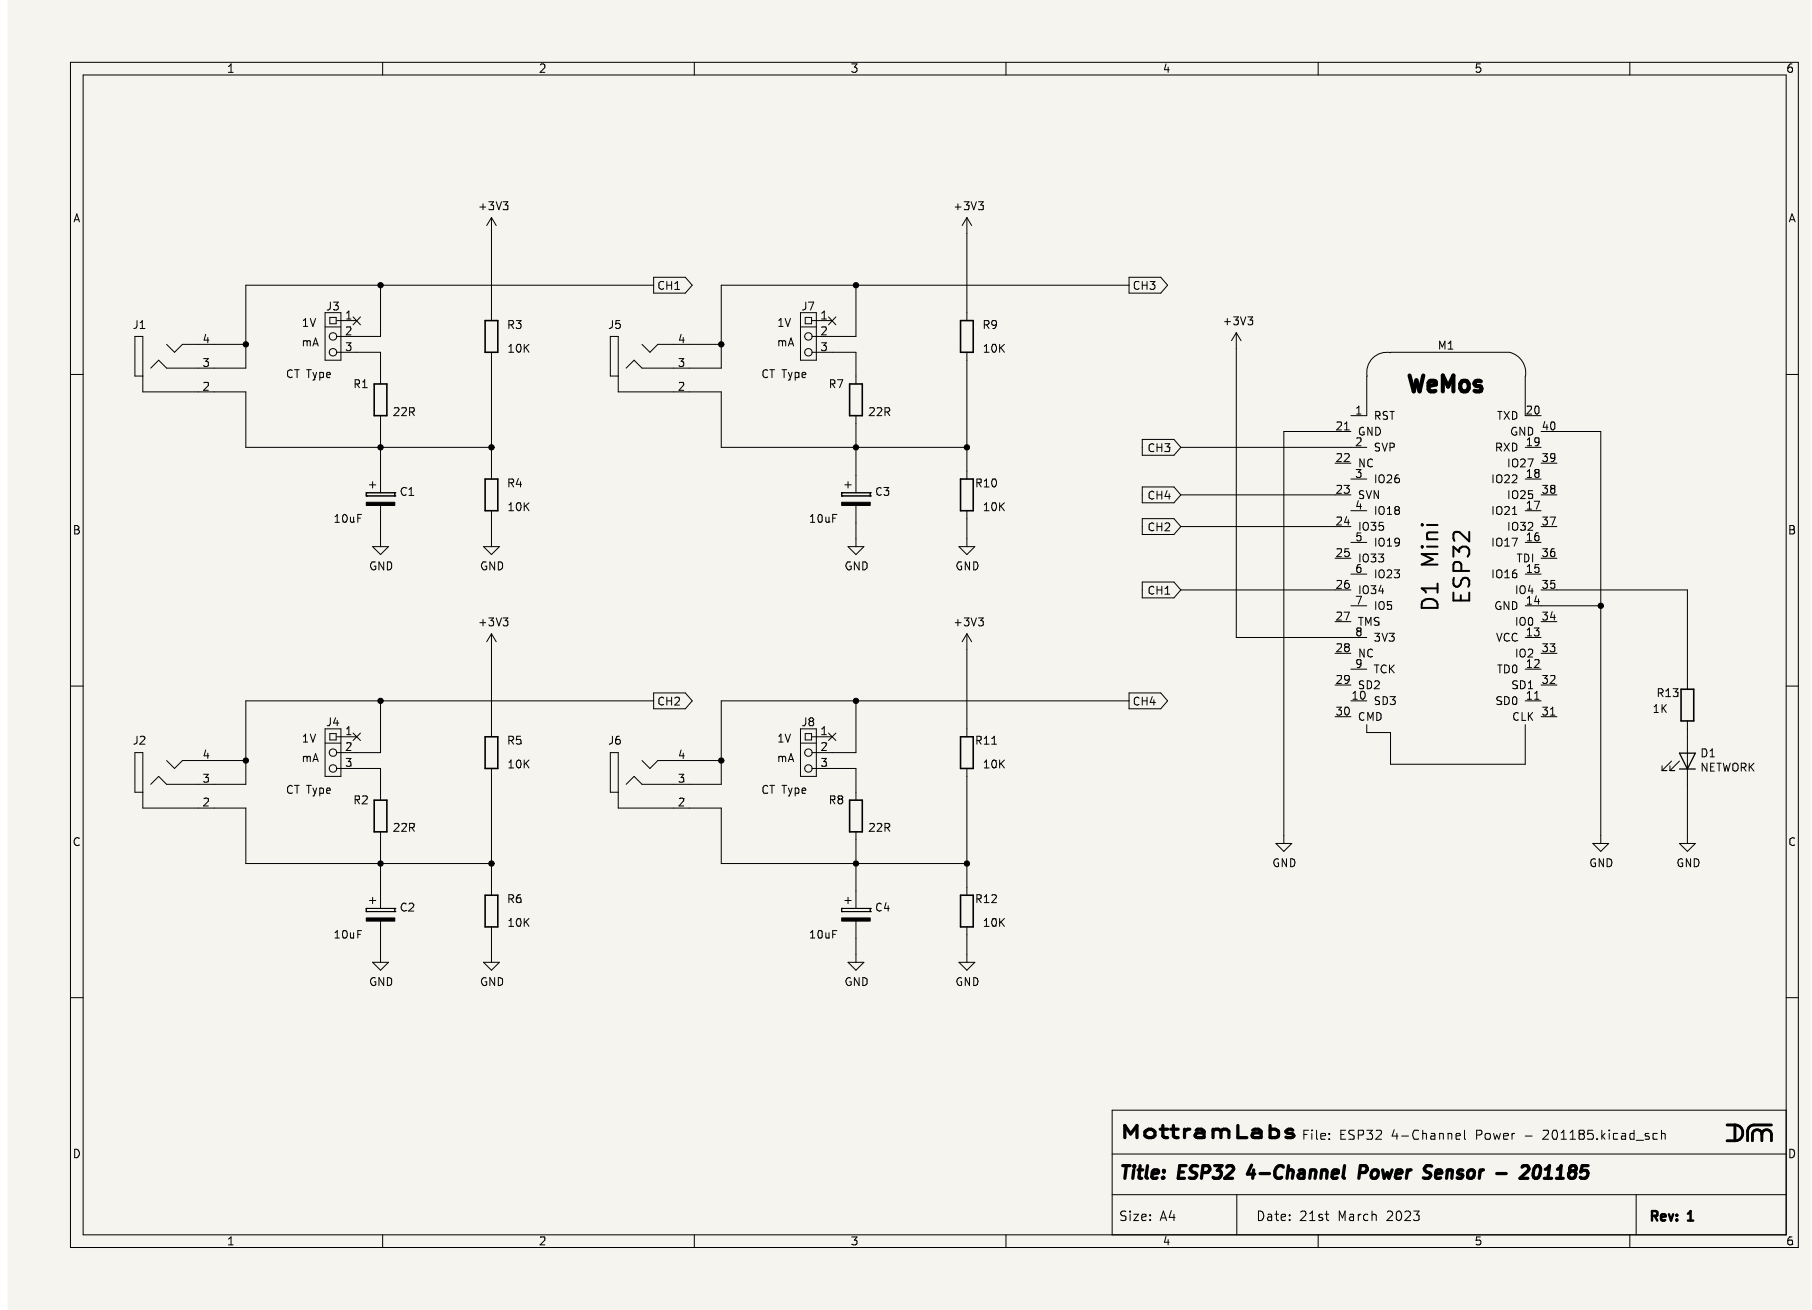
[picture p8: page 1]
