Mottramlabs/ESP32-4-Channel-Mains-Current-Sensor/SCH201188.pdf

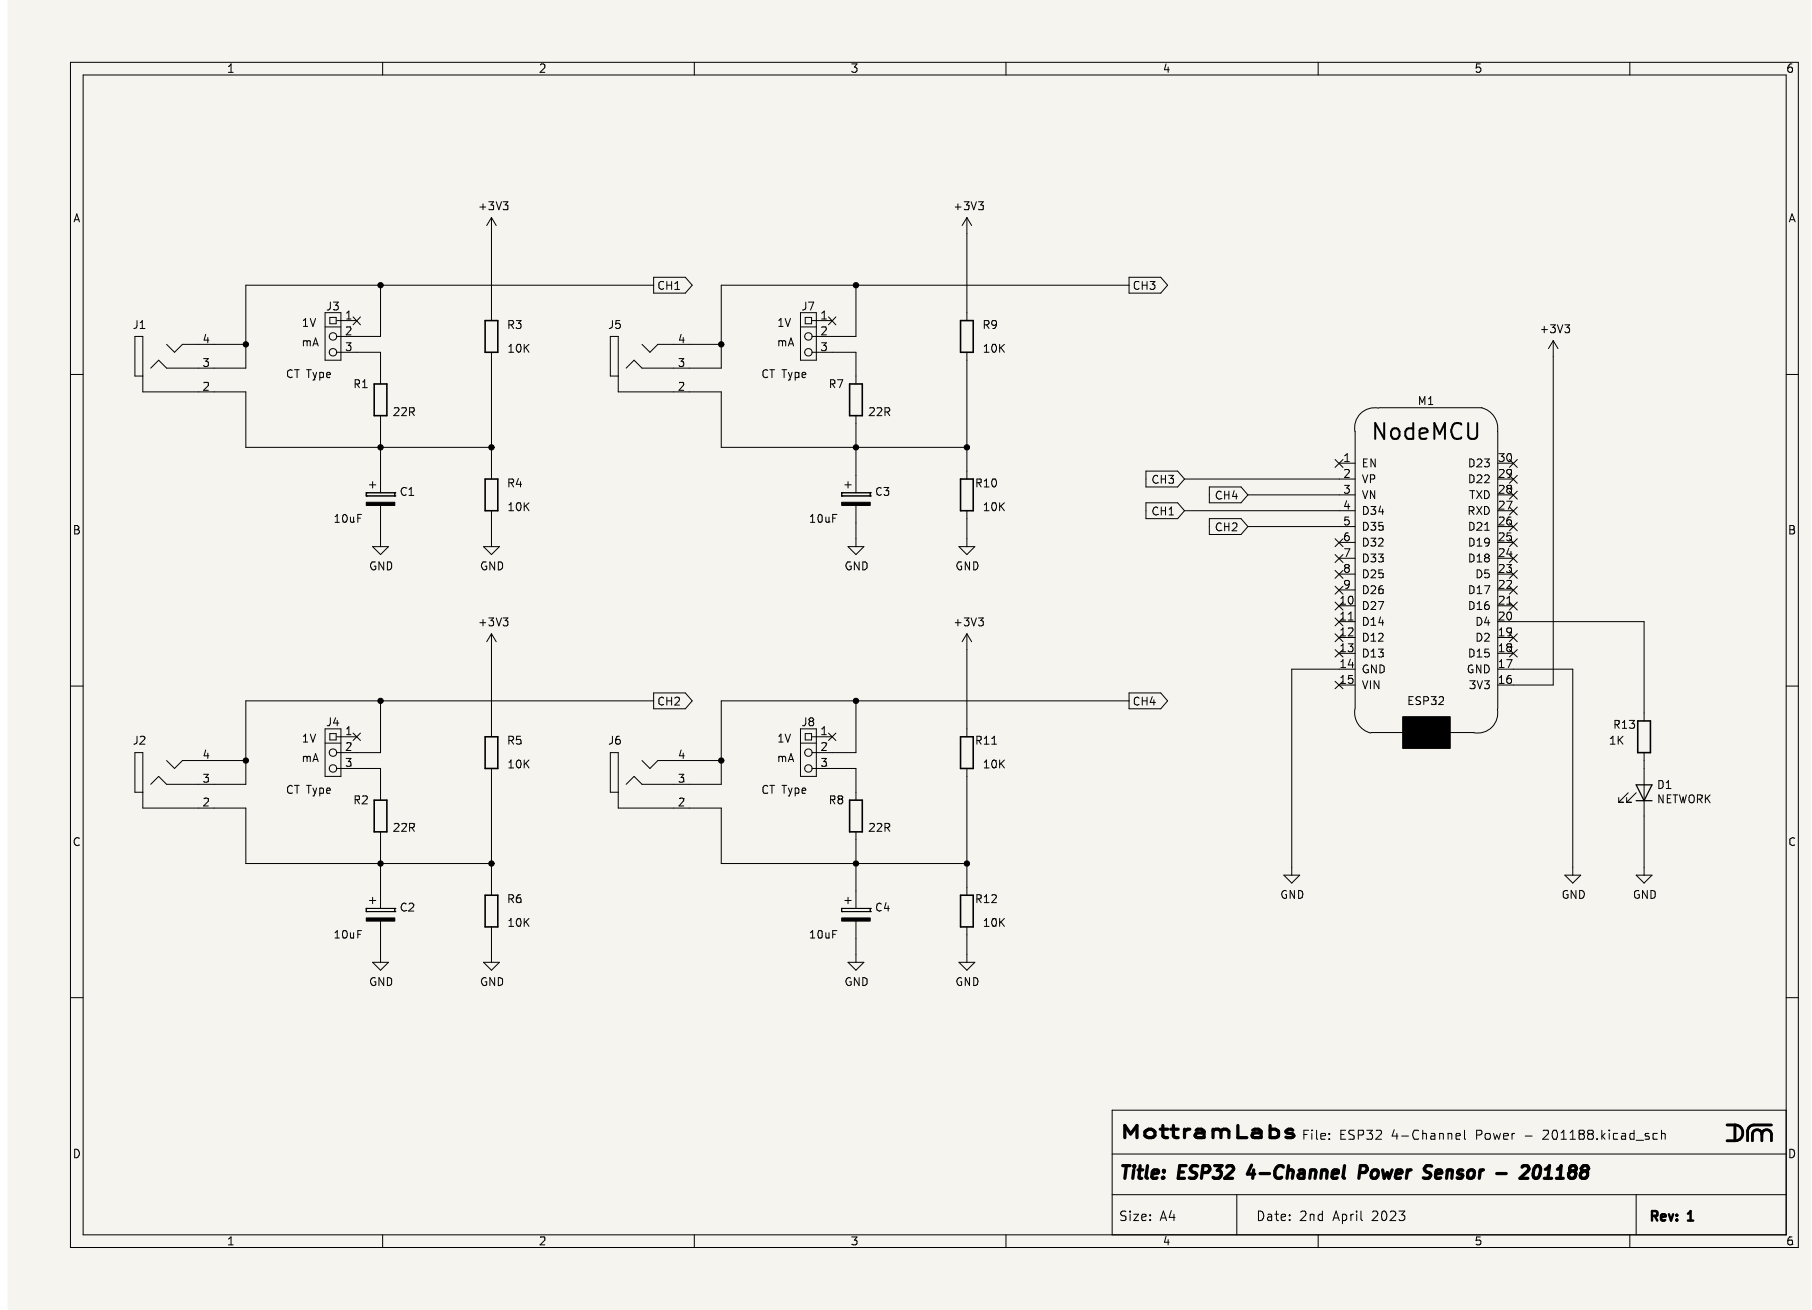
[picture p9: page 1]
